esden/bitmagic/(threads)

Thread 2 (2020-10-26):

Switch to USB Type C connector

securelyfitz, 2020-10-26:
A single, universal connector for all tools makes it easier and minimizes unique cables.
TYPE-C-31-M-12 worked well for tigard, including paste-in-hole for soldering.

Thread 3 (2021-01-08):

Which version of KiCad are used?

Droid-MAX, 2021-01-08:
my KiCad version: 5.1.9-stable
can not open bitmagic basic v1.1a project files, prompt error about incompatible

esden, 2021-01-08:
You need KiCad 5.99 aka KiCad nightly build to open the files.

Hope it helps.

Closed 2021-01-08.
