esden/bitmagic/bm1/v0.1/bm1-sch.pdf

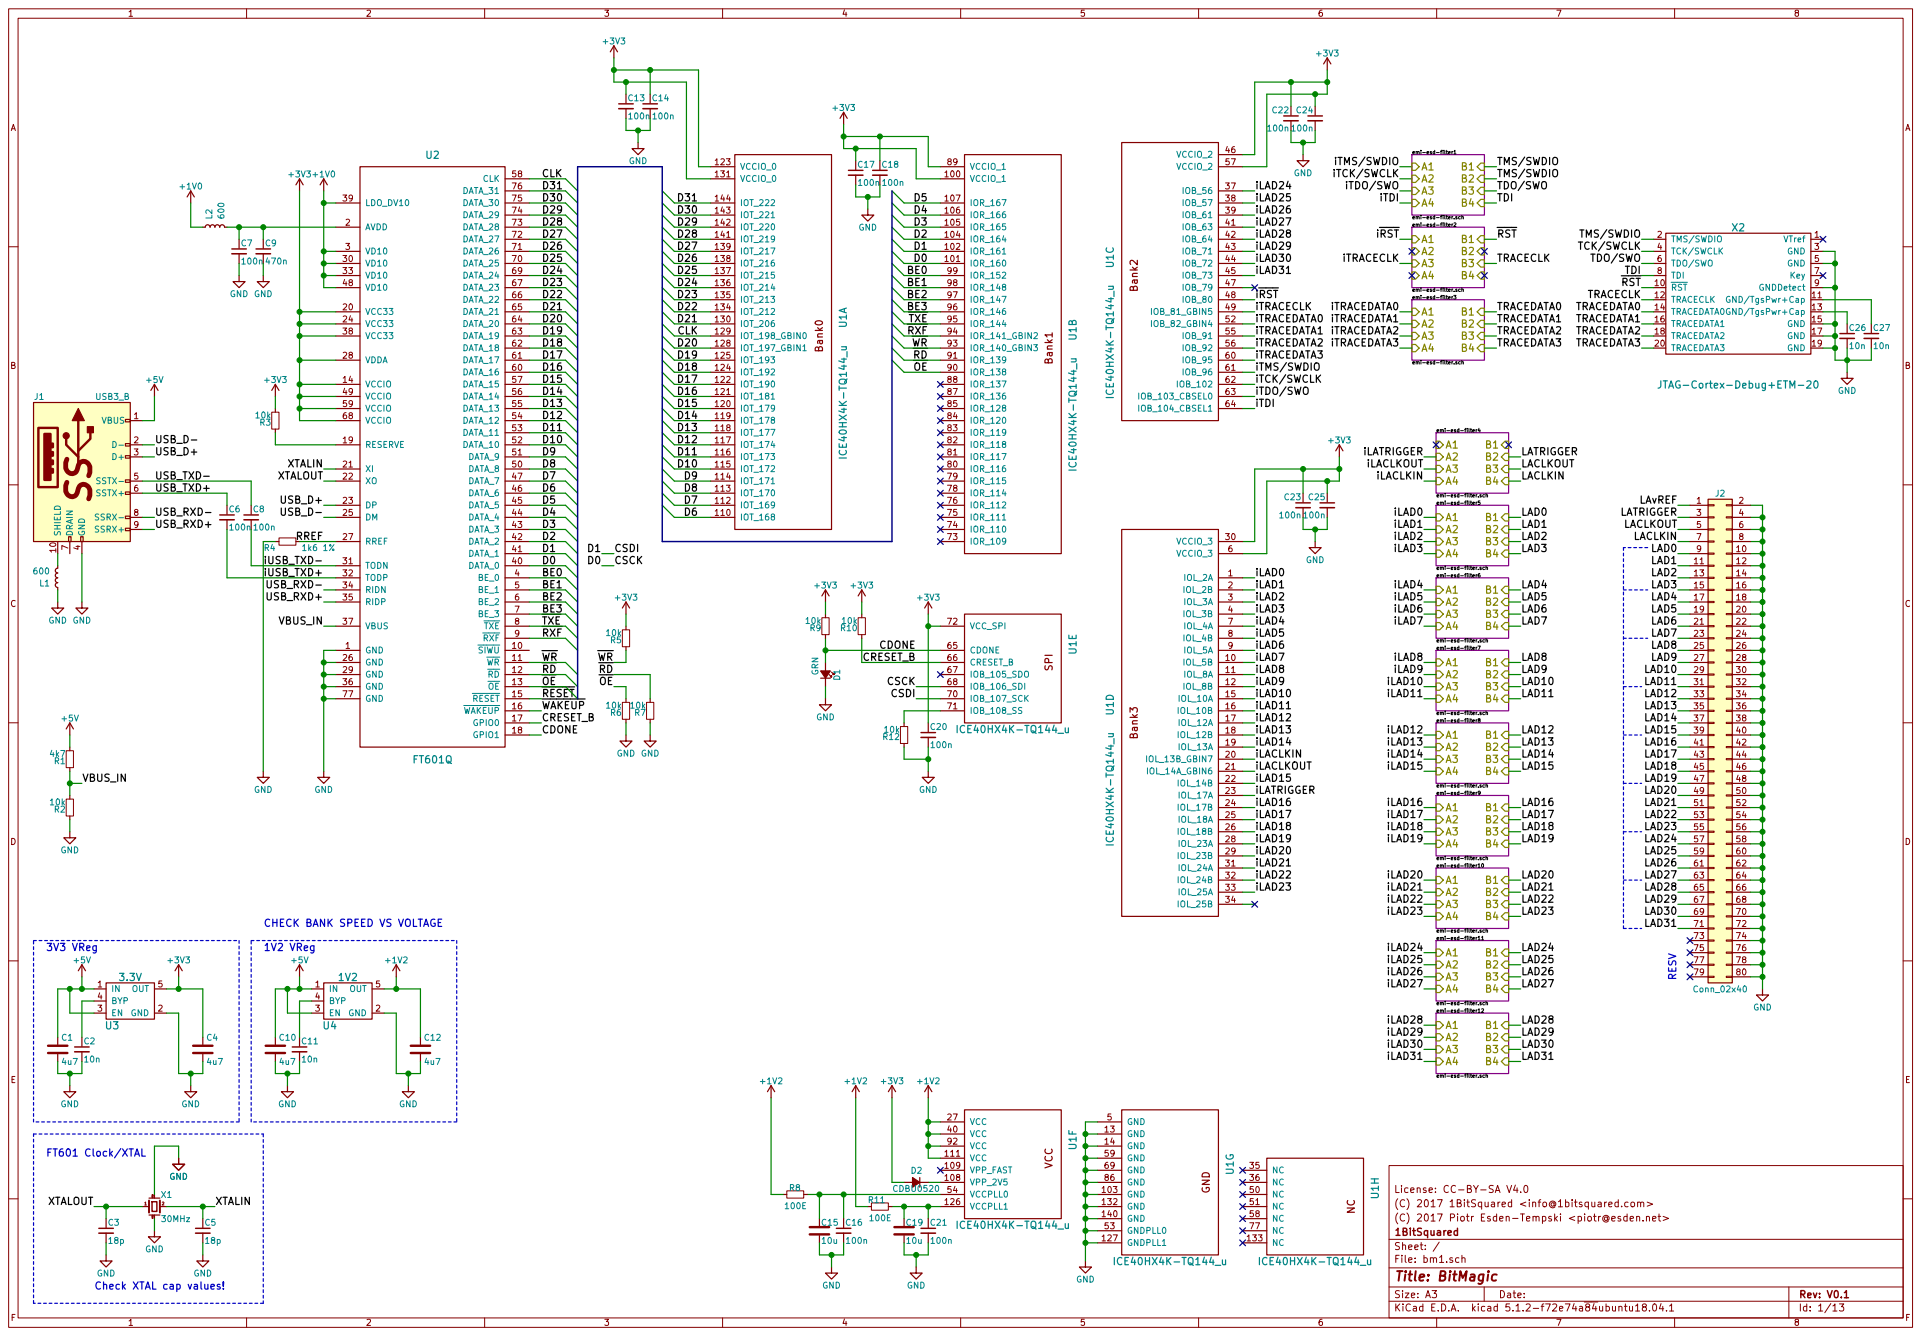
[picture p1: page 1]

CHECK BANK SPEED VS VOLTAGE

License: CC-BY-SA V4.0
(C) 2017 1BitSquared <info@1bitsquared.com>
(C) 2017 Piotr Esden-Tempski <piotr@esden.net>
File: bm1.sch Sheet: / 1BitSquared

Check XTAL cap values!

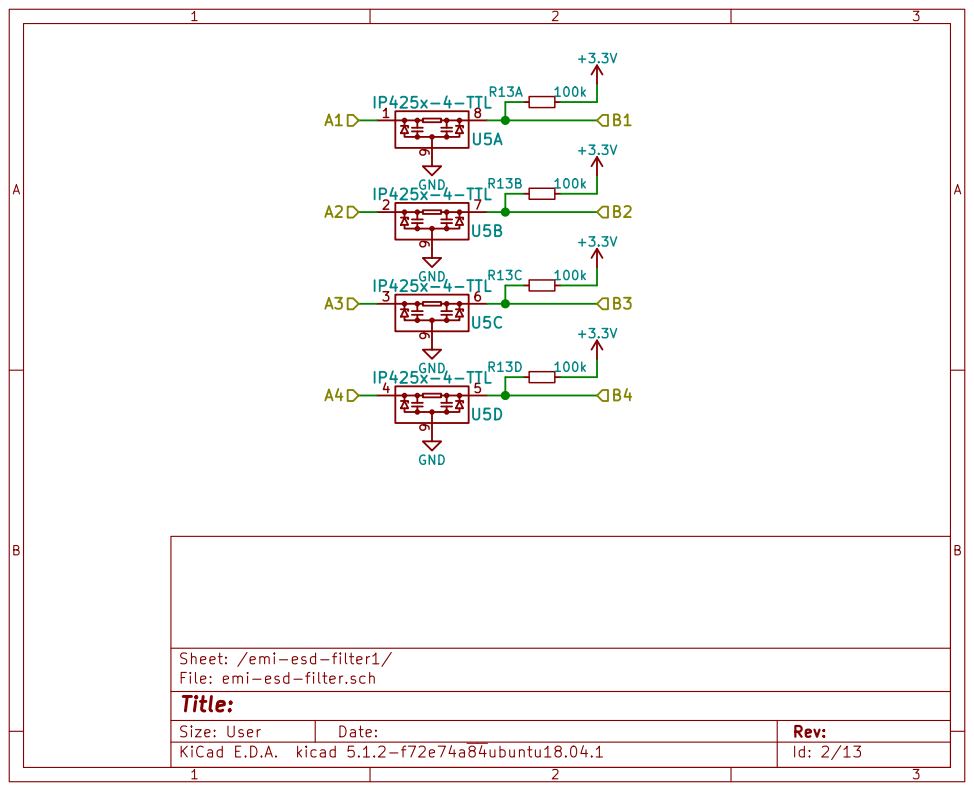
[picture p2: page 2]

Id: 2/13 Title: File: emi-esd-filter.sch Sheet: /emi-esd-filter1/

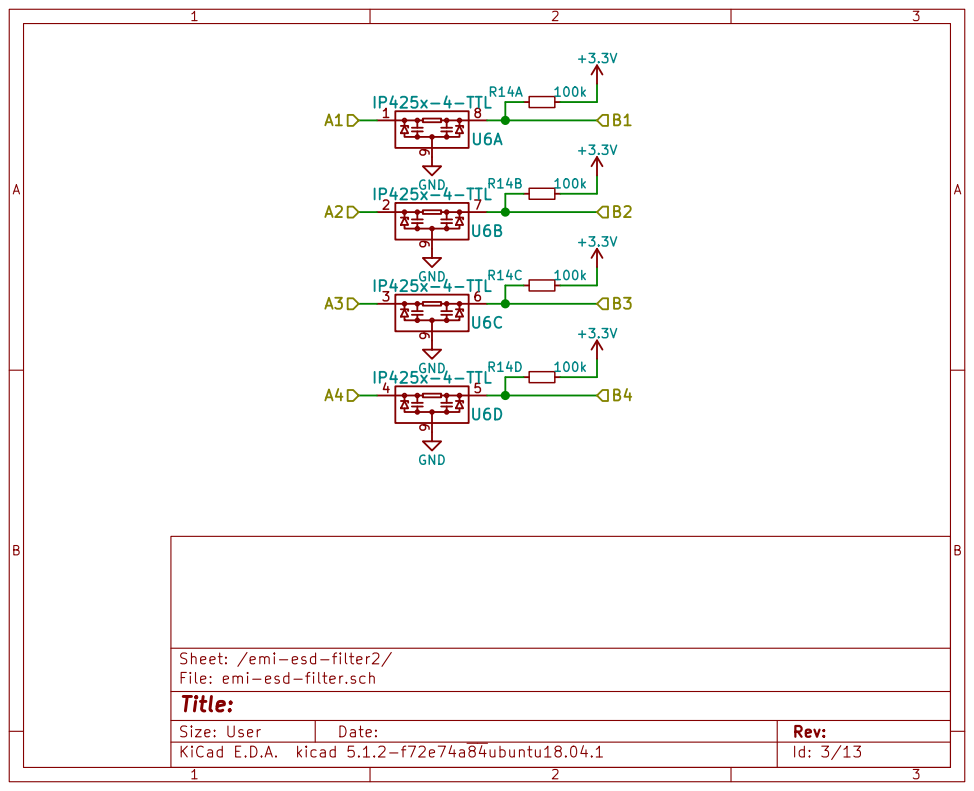
[picture p3: page 3]

Id: 3/13 Title: File: emi-esd-filter.sch Sheet: /emi-esd-filter2/

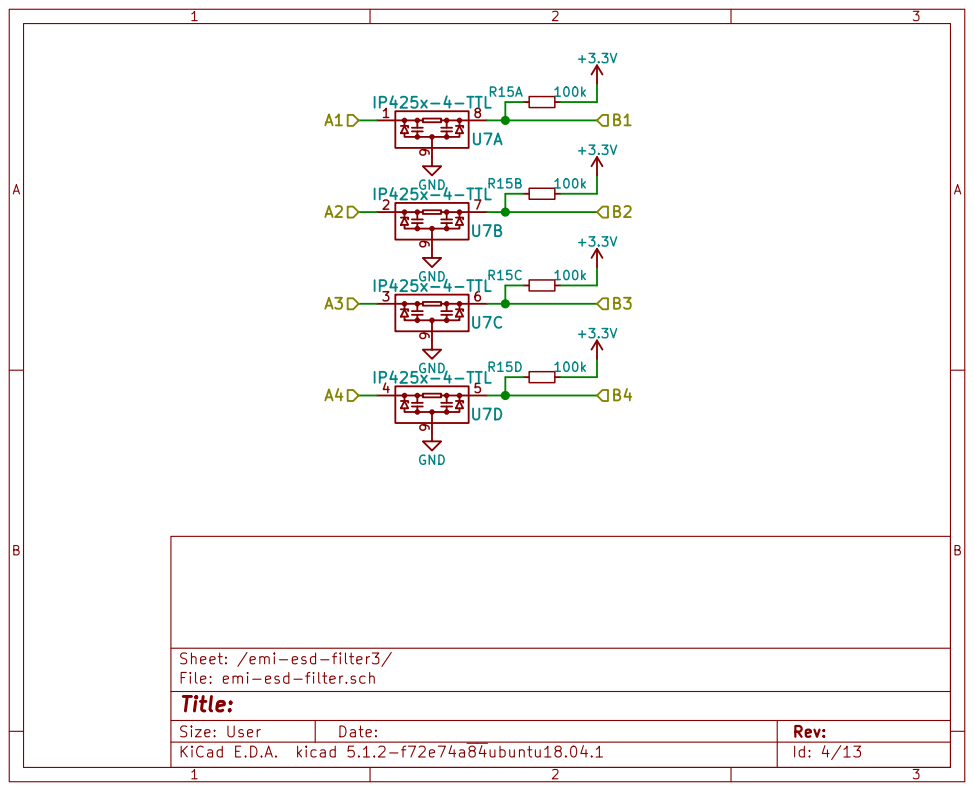
[picture p4: page 4]

Id: 4/13 Title: File: emi-esd-filter.sch Sheet: /emi-esd-filter3/

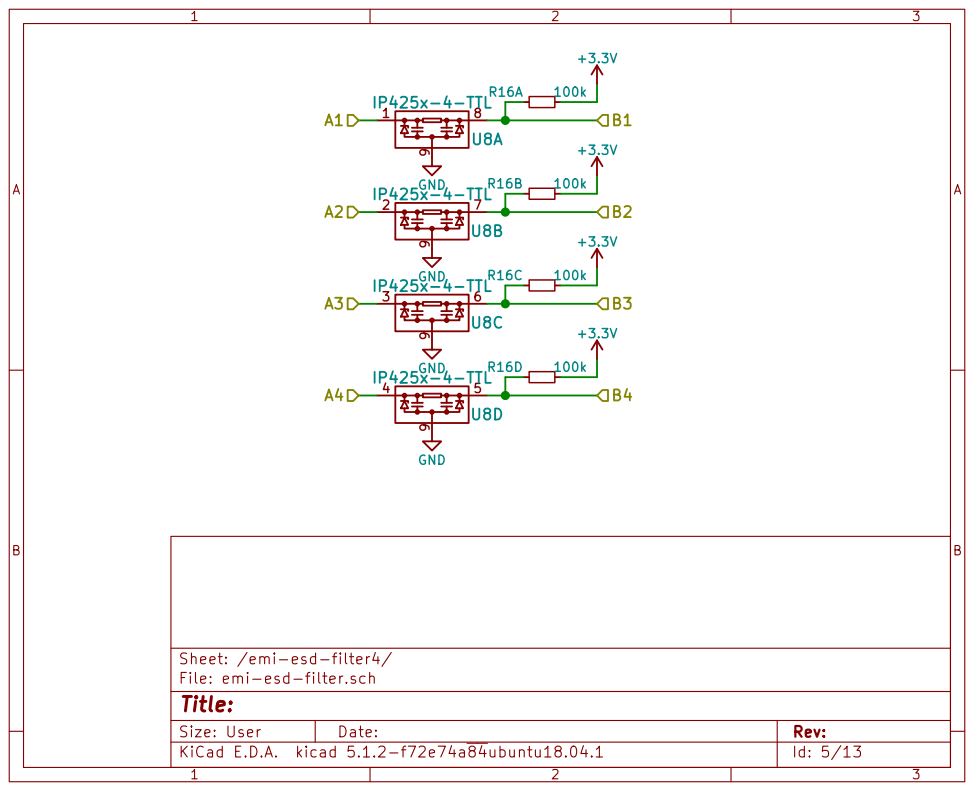
[picture p5: page 5]

Id: 5/13 Title: File: emi-esd-filter.sch Sheet: /emi-esd-filter4/

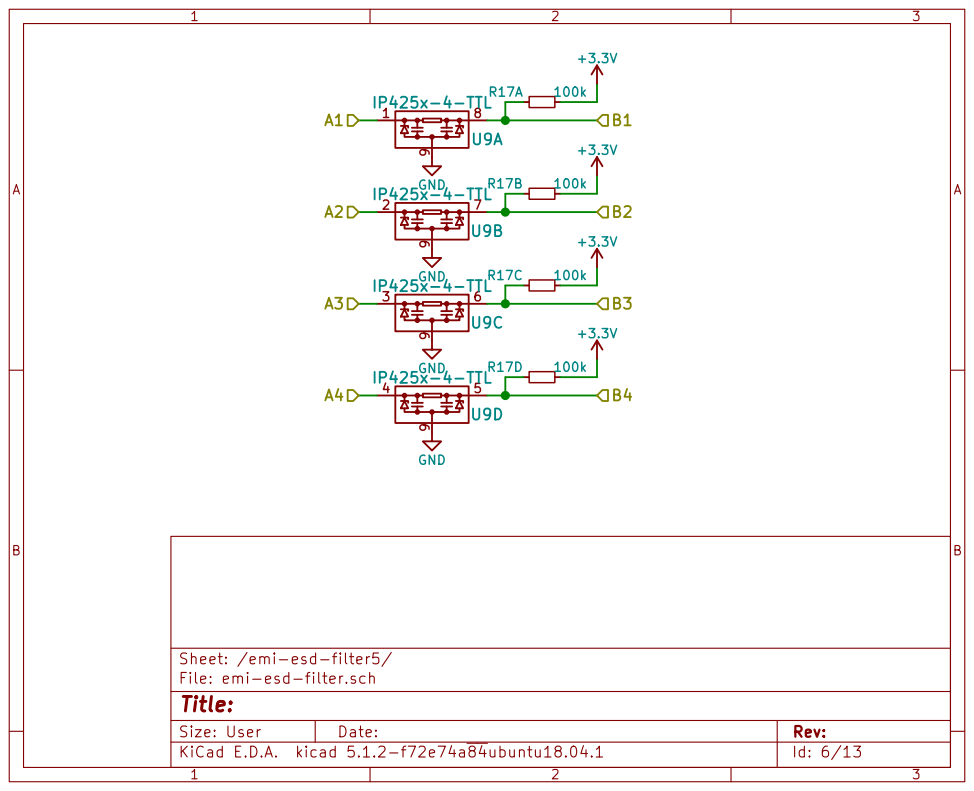
[picture p6: page 6]

Id: 6/13 Title: File: emi-esd-filter.sch Sheet: /emi-esd-filter5/

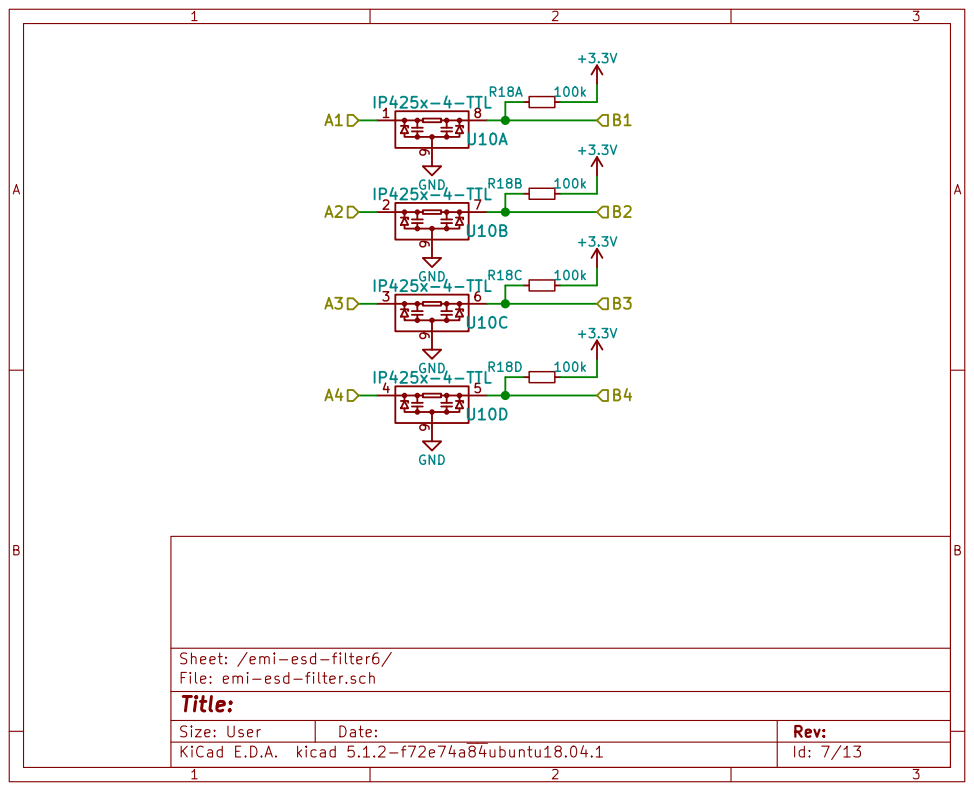
[picture p7: page 7]

Id: 7/13 Title: File: emi-esd-filter.sch Sheet: /emi-esd-filter6/

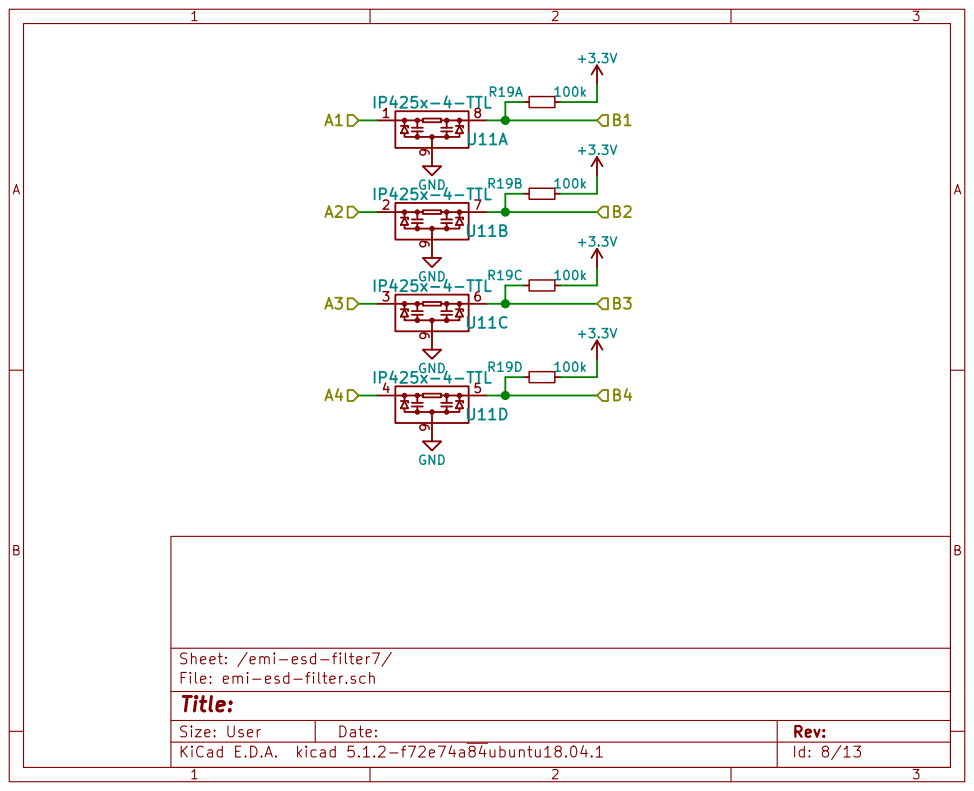
[picture p8: page 8]

Id: 8/13 Title: File: emi-esd-filter.sch Sheet: /emi-esd-filter7/

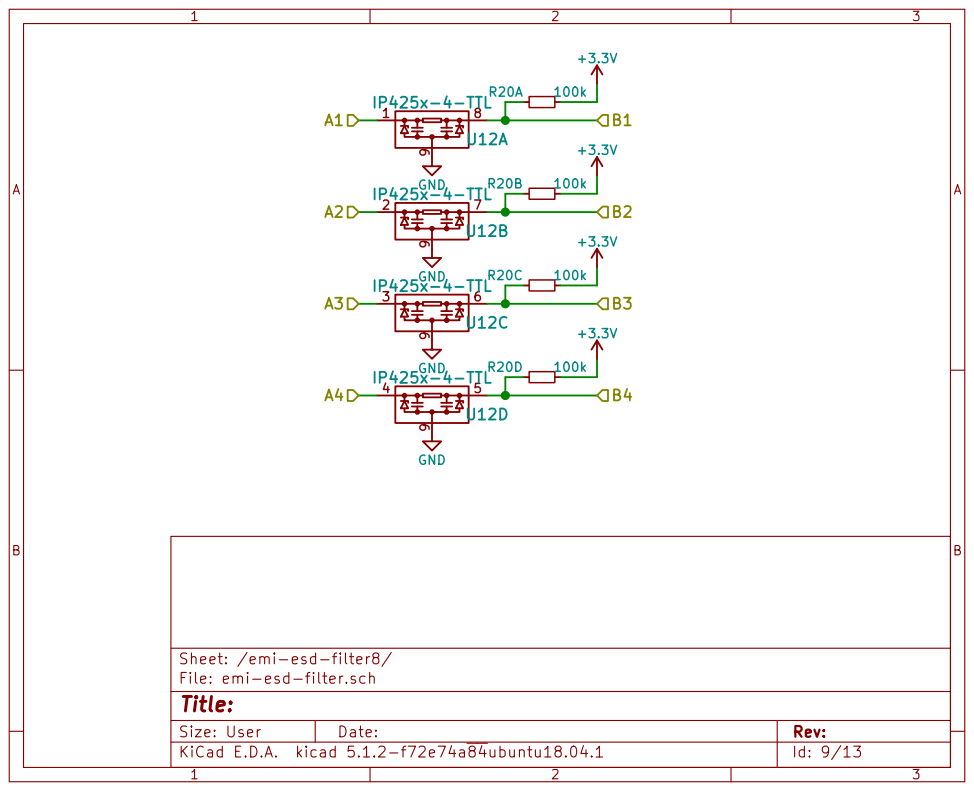
[picture p9: page 9]

Id: 9/13 Title: File: emi-esd-filter.sch Sheet: /emi-esd-filter8/

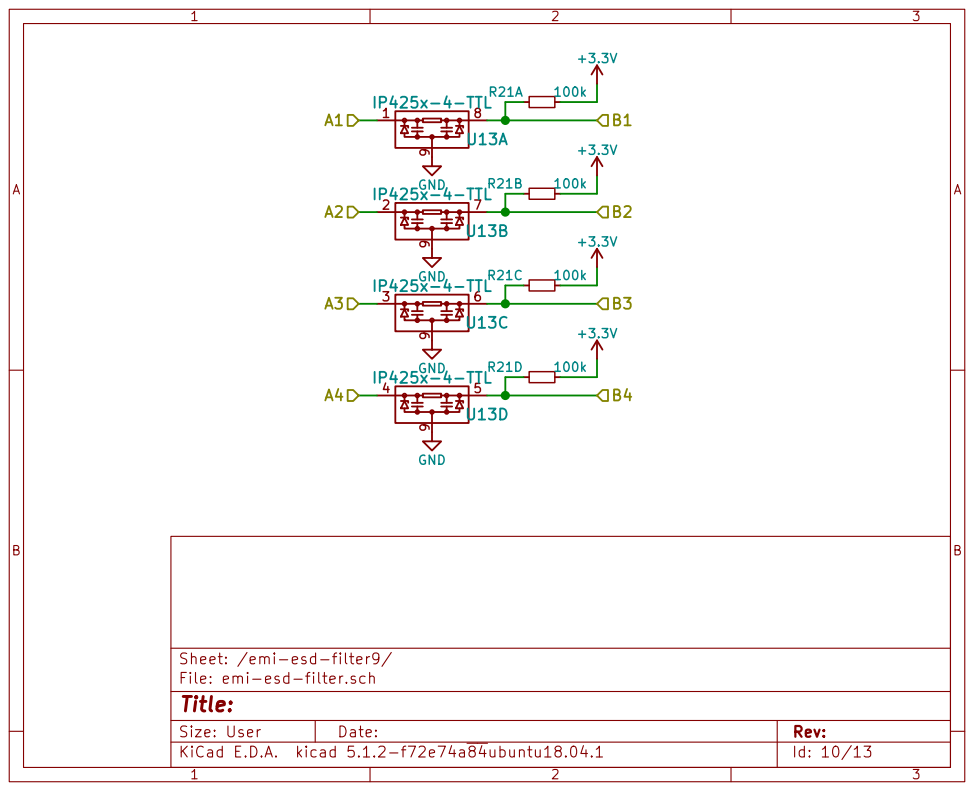
[picture p10: page 10]

Id: 10/13 Title: File: emi-esd-filter.sch Sheet: /emi-esd-filter9/

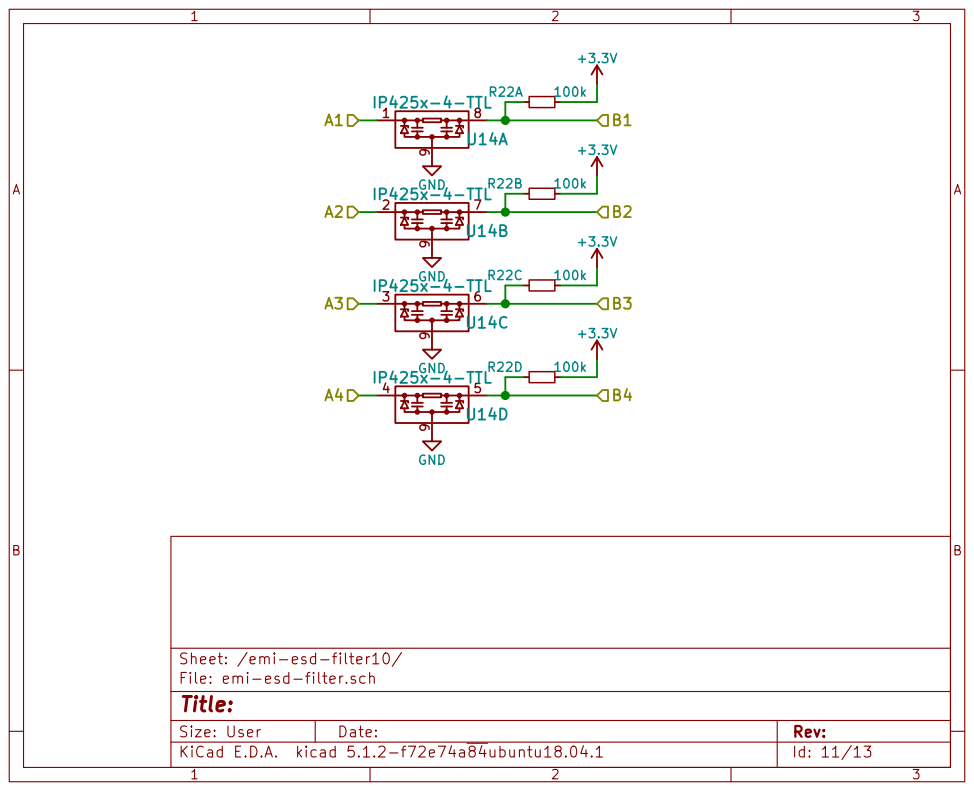
[picture p11: page 11]

Id: 11/13 Title: File: emi-esd-filter.sch Sheet: /emi-esd-filter10/

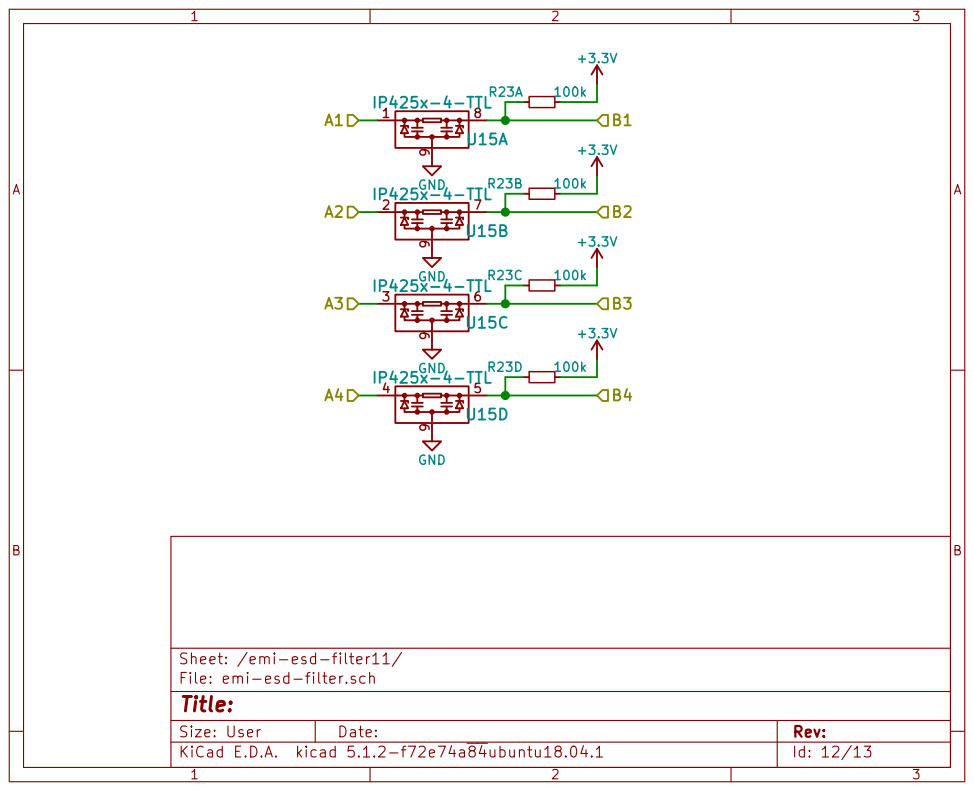
[picture p12: page 12]

Id: 12/13 Title: File: emi-esd-filter.sch Sheet: /emi-esd-filter11/

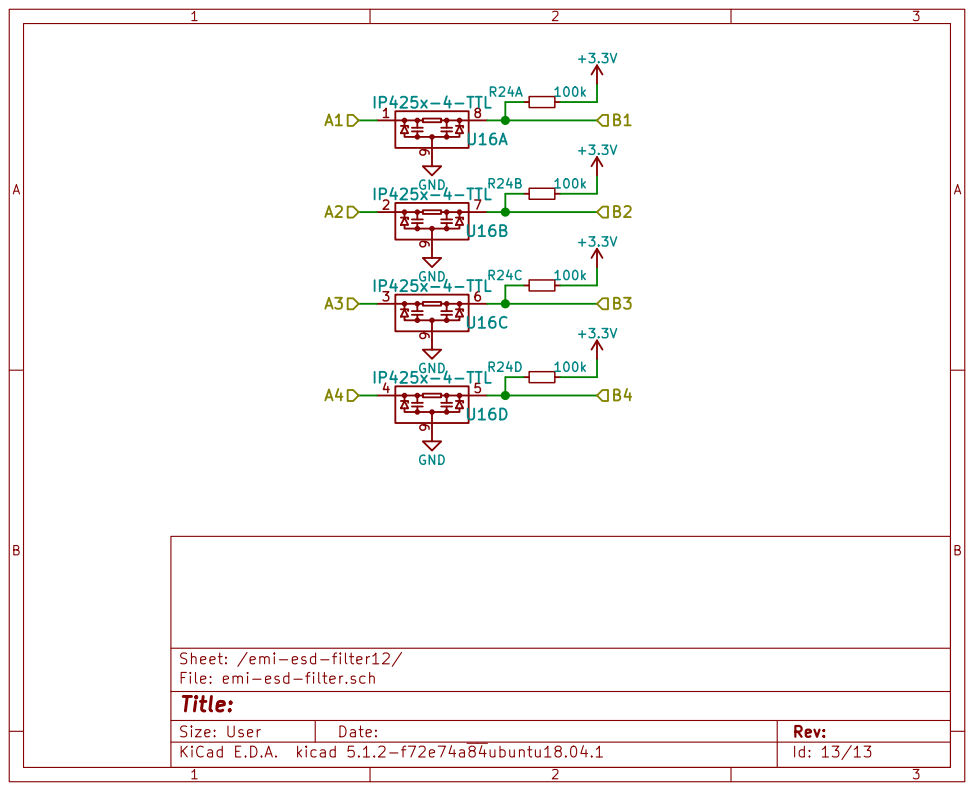
[picture p13: page 13]

Id: 13/13 Title: File: emi-esd-filter.sch Sheet: /emi-esd-filter12/
