esden/bitmagic/adapters/bmb-pin-header-v1_0a/bmb-pin-header-sch.pdf

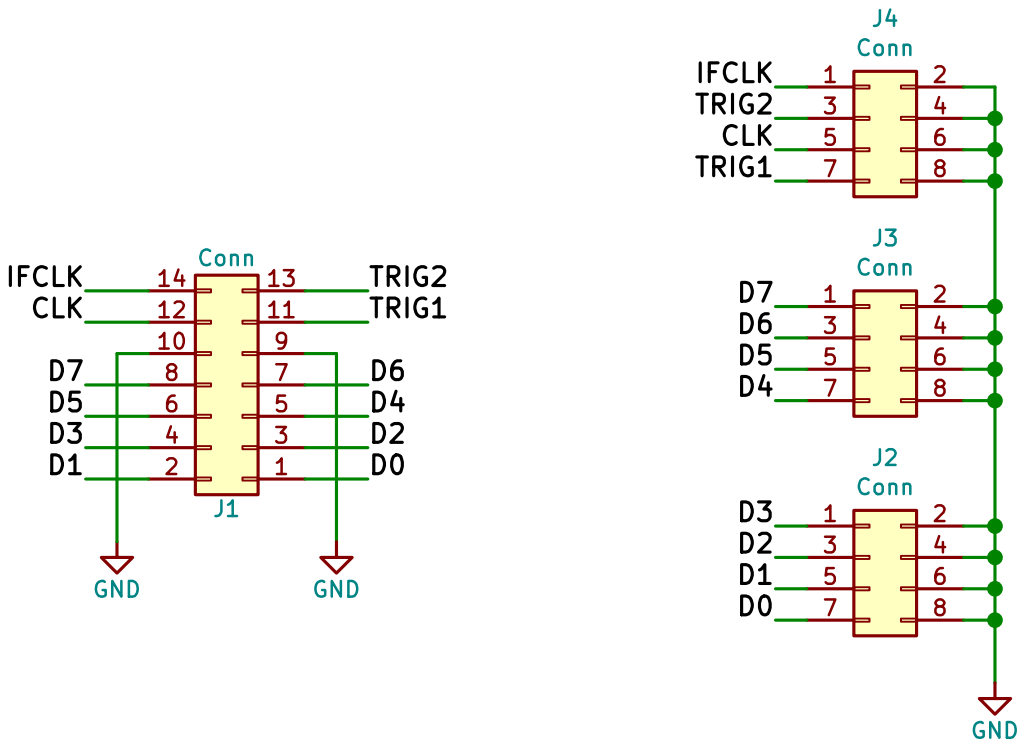
[picture p14: page 1]

File: bmb-pin-header.sch Sheet: /
Id: 1/1 Title:
