esden/bitmagic/bmb/v1.0a/bitmagic-basic-sch.pdf

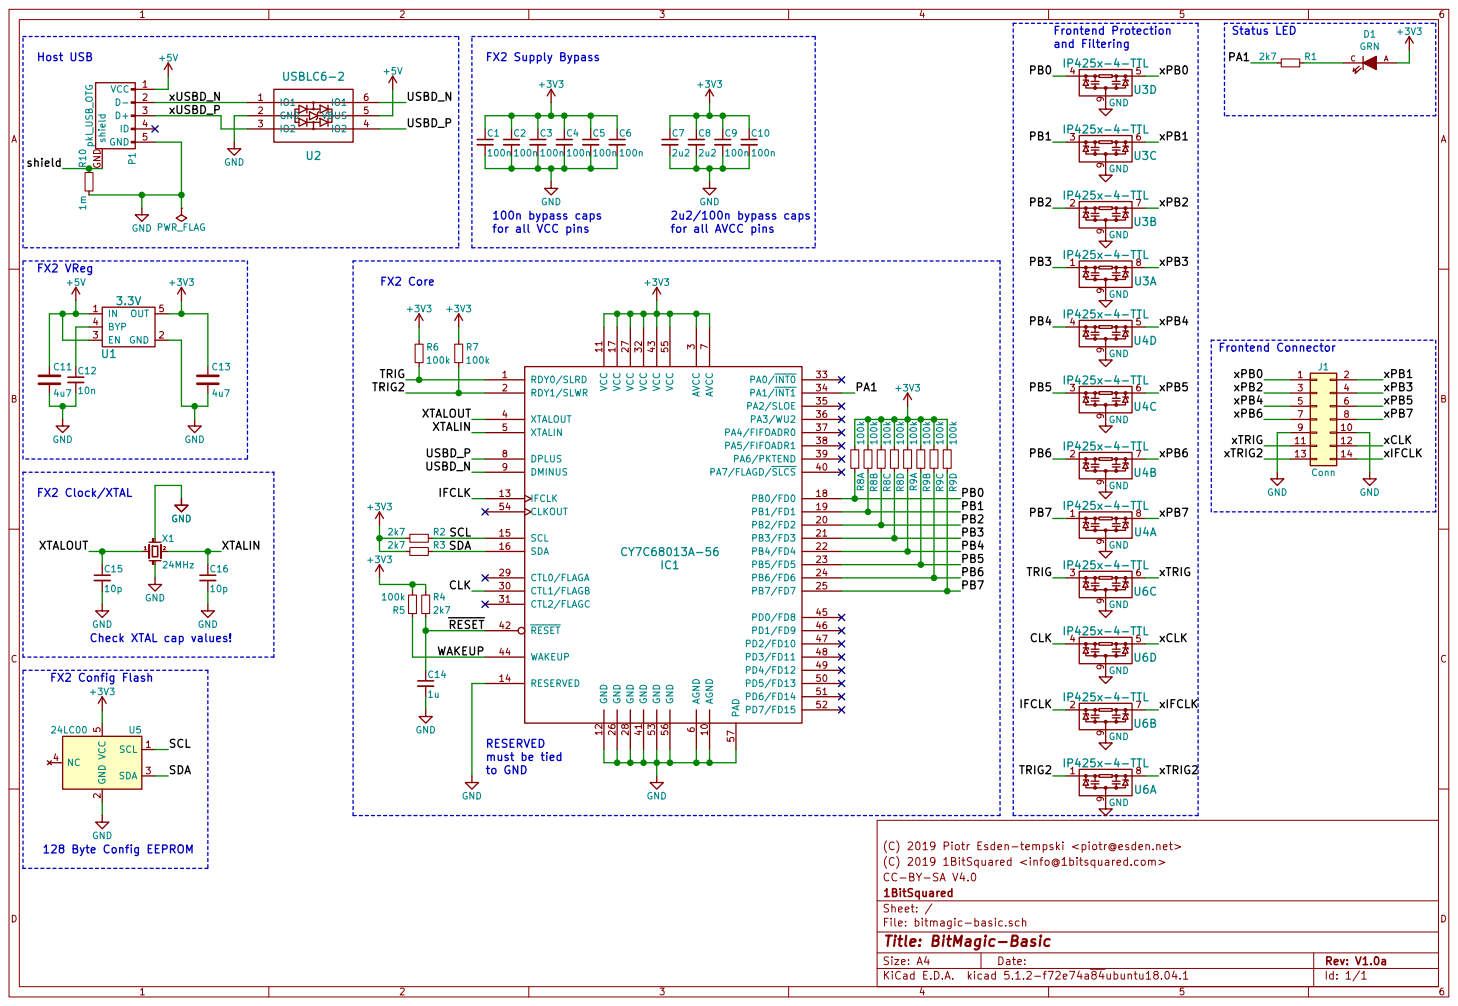
[picture p15: page 1]

and Filtering
IP425x-4-TTL GND
PB0 PB1 PB2 PB3 PB4 PB5 PB6 PB7 TRIG
IP425x-4-TTL GND GND GND

IP425x-4-TTL

2u2/100n bypass caps
for all AVCC pins

7 DPLUS 8 DMINUS 9 AGND 10 PB2/FD2 20 CTL1/FLAGB 30 PA7/FLAGD/SLCS 40 PD5/FD13 50 VCC 11 PB3/FD3 21 CTL2/FLAGC 31 GND 41 PD6/FD14 51 GND 12 PB4/FD4 22 VCC 32 RESET 42 PD7/FD15 52

(C) 2019 Piotr Esden-tempski <piotr@esden.net>
(C) 2019 1BitSquared <info@1bitsquared.com>
File: bitmagic-basic.sch Sheet: / 1BitSquared CC-BY-SA V4.0

Id: 1/1 Title: BitMagic-Basic
