esden/bitmagic/adapters/bmb-pin-header-v1_0a/bmb-pin-header.kicad_pcb

## KiCad design adapters/bmb-pin-header-v1_0a/bmb-pin-header.kicad_pcb (2019-06-05)

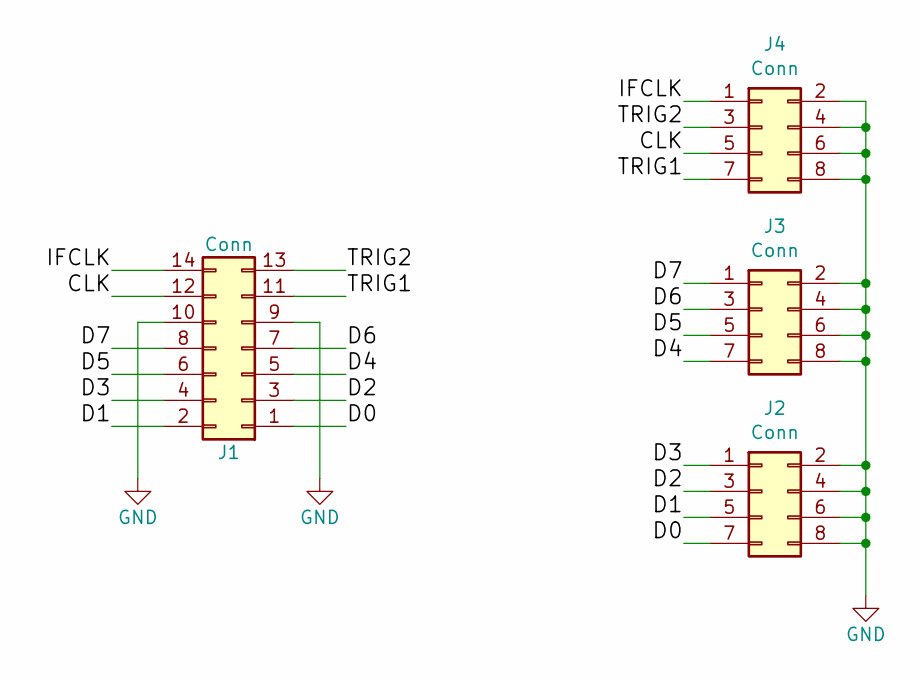
[picture p18: schematic bmb-pin-header.sch, BitMagic Basic to 100mil header adapter]

Parts:
J1: Conn; PinHeader_2x07_P1.27mm_Vertical_SMD
J2, J3, J4: Conn; PinHeader_2x04_P2.54mm_Horizontal

Connections:
/CLK: J1.12, J4.5
/D0: J1.1, J2.7
/D1: J1.2, J2.5
/D2: J1.3, J2.3
/D3: J1.4, J2.1
/D4: J1.5, J3.7
/D5: J1.6, J3.5
/D6: J1.7, J3.3
/D7: J1.8, J3.1
/IFCLK: J1.14, J4.1
/TRIG1: J1.11, J4.7
/TRIG2: J1.13, J4.3
GND: J1.9, J1.10, J2.2, J2.4, J2.6, J2.8, J3.2, J3.4, J3.6, J3.8, J4.2, J4.4, J4.6, J4.8

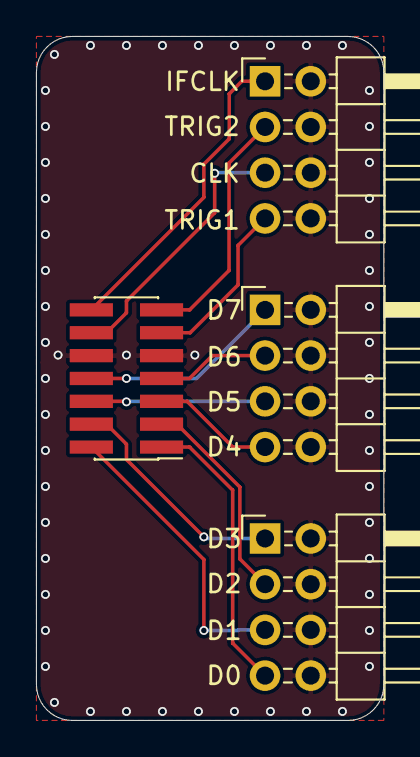
[picture p19: board bmb-pin-header.kicad_pcb from above]

Board: 2 copper layers, 19.3 x 38.0 mm, 4 parts (0 on the bottom side), 13 nets.
