esden/bitmagic/(commit log)

2017-10-30 Initial commit.
    [bm1.kicad_pcb, bm1.sch, emi-esd-filter.sch]
2019-06-01 Initial commit of bitmagic basic V1.0a.
    [bitmagic-basic.kicad_pcb, bitmagic-basic.sch]
2019-06-02 Improved the IP425 footprint.
    [bitmagic-basic.kicad_pcb]
2019-06-03 Corrected 3d model paths.
    [bitmagic-basic.kicad_pcb]
2019-06-04 Minor updates.
    [bitmagic-basic.kicad_pcb]
2019-06-04 Corrected connector pads to be roundrect.
    [bitmagic-basic.kicad_pcb]
2019-06-05 Initial commit of the bmb to 100mil pin header adapter.
    [bmb-pin-header.kicad_pcb, bmb-pin-header.sch]
2019-06-30 Initial commit of V1.0b.
    [bitmagic-basic.kicad_pcb, bitmagic-basic.sch]
2019-06-30 Corrected LED and pullup resistor values in V1.0a.
    [bitmagic-basic.kicad_pcb, bitmagic-basic.sch]
2019-07-20 Added pdf schematic for bm1.
2020-12-03 bmb 1.1a: Initial commit, swaps the USB Micro B for USB-C.
    [bitmagic-basic.kicad_pcb, bitmagic-basic.kicad_sch]
2020-12-12 bitmagic-basic: minor fixes for production
    [bitmagic-basic.kicad_pcb]
2020-12-12 bmb: Updated manufacturing data.
    [bitmagic-basic.kicad_pcb, bitmagic-basic.kicad_sch]
