esden/bitmagic/(notices)

Notices in the files:
bmb/v1.0b/bitmagic-basic.kicad_pcb:
CC-BY-SA 4.0
bmb/v1.1a/bitmagic-basic.kicad_sch:
(C) 2019-2020 1BitSquared
(C) 2019-2020 Piotr Esden-Tempski
